tgtakaoka/kicad-library/README.md

## KiCad parts library

### ``connector``
Custom connector and socket.

 - ``DIP-48_W10.16mm.kicad_mod`` 48 pin ZIF socket footprint
 - ``bionic_connector`` custom connector for [Bionic projects](https://github.com/tgtakaoka/RetroCyborg)
 - ``DIP-48_W7.62mm.kicad_mod`` ``bionic_connector`` foot print

### ``cpu-16bit``
Retro 16-bit MPU/CPU.

 - ``MC68008P`` Motorola 8-bit MC68000 DIP-48
 - ``MN1613`` Panasonic MN1613
 - ``MN1613A`` Panasonic MN1613A DIP-42
 - ``NS32016N`` Natinal Semiconductor 16-bit NS32032 DIP-48
 - ``P8086`` Intel i8086
 - ``P8088`` Intel 8-bit i8086
 - ``P8095BH`` Intel i8096 DIP-48
 - ``TMS32C010NL`` Texas Instrument TMS32010 DSP
 - ``TMS9981`` Texas Instrument TMS9981
 - ``TMS9995`` Texas Instrument TMS9995
 - ``TMS99105`` Texas INstrumet TMS99105
 - ``uPD70108`` NEC V20 8-bit CMOS i80186 with i8080 emulation mode
 - ``uPD70116`` NEC V30 CMOS i80186 with i8080 emulation mode
 - ``Z8001`` Zilog Z8001 DIP-48
 - ``Z8002`` Zilog Z8002

### ``cpu-8bit``
Retro 8-bit MPU/CPU.

 - ``CDP1802`` RCA 1802
 - ``F3850`` Fairchild F8
 - ``HD6120`` Harris HD-6120 12-bit CPU
 - ``HD6301V1P`` Hitach CMOS MC6801, MC6803
 - ``IM6100`` Intersil IM6100 12-bit CPU
 - ``INS8060`` National Semiconductor SC/MP II
 - ``INS8070`` National Semiconductor SC/MP III
 - ``MC68HC11A8P`` Motorola MC68HC11 DIP-48
 - ``MC68HC11D3P`` Motorola MC68HC11 DIP-40
 - ``MC6800P`` Motorola MC6800
 - ``MC6802P`` Motorola MC6802
 - ``MC6803P`` Motorola MC6801, MC6803
 - ``MC6809P`` Motorola MC6809
 - ``MC6809EP`` Motorola MC6809E
 - ``MC146805E2P`` Motorola MC146805 DIP-40
 - ``MOS6502`` MOS Technology 6502, Rockwell 65C02, CMD 65SC02
 - ``NSC800N`` National Semiconductor CMOS Z80 with i8085 bus
 - ``P8048AH`` Intel i8048
 - ``P8051AH`` Intel i8051
 - ``P8085AH`` Intel i8085
 - ``TMP90C802A`` Toshiba TLCS-90
 - ``TMS7001`` Texas Instrument TMS7001
 - ``W65C02S`` Western Design Center CMOS 6502
 - ``W65C816`` Western Design Center CMOS 65816
 - ``Z8400`` Zilog Z80
 - ``Z8691`` Zilog Z8
 - ``Z8800`` Zilog Super Z8 DIP-48

### ``logic7400``
Standard TTL 7400 series.

 - ``74HCT126`` 74HCT126 quad tristate-buffer

### ``dcdc``
DC-DC Converter.

 - ``MAU105`` MINMAX MAU100 Series 5V in, 15V out, max 67mA
