tgtakaoka/kicad-library/(commit log)

2022-11-20 Convert to KiCAD 6 format
2023-12-12 Cleanup pre KiCad7 files
2023-12-14 Update connectors
2024-03-24 [connector] Add IC sockets with cortyard
2024-04-29 [bionic] Add library for RetroBionic
    [LED_CSL1901UW1_ROM.step, SOT-23_MC_MCH.step]
2024-10-29 Add USB Serial board GY232V2
2024-11-01 [11AA010-I_TT] Fix critical pin assignment bug
2024-11-01 Chane bionic library to project scope
    [kicad-library.kicad_pcb, kicad-library.kicad_sch]
2024-11-01 [bionic] Fix LED pin function
2025-01-10 [bionic] Update LED symbol
2025-02-28 [bionic] Remove extra pins and +15V pins
2025-03-06 [3m] Add 3M PLCC SMT Socket
2025-03-06 [aries] Add Aries 48-pin ZIF DIP Socket
2025-03-06 [rhom] Add Rhom LED
2025-03-06 [murata] Add Murata SMD inductor and Diode
2025-03-15 [nisshinbo] Fix NJW4191 pin name
2025-03-15 [bionic] Change DIP-64 footprint and 3D
2025-11-10 [3m] update 3D model from traceparts.com
2025-12-24 [3M] 84-pin PLCC SMT socket
2025-12-24 [TI] Cleanup foot print silk
2026-03-05 [ti] Add LDO, Driver, and 1G-gate
2026-10-26 [bionic] Model the SMD Bionic connector as populated
    Unpopulated positions have no pins and both end pins are straight
    through-hole, as on the boards; bionic_smt_header.py derives the model
    from KiCad's PinHeader_1x24 SMD model.
2026-10-26 [bionic] Add DIP-64 and SDIP-64 socket 3D models
    DIP-64 is two Akizuki 101591 (Neltron 6604S) round-pin strips cut to
    1x32; neltron.pretty/6604S_strip.py builds the strip from its datasheet
    dimensions. SDIP-64 is the Preci-Dip 117-83-764-41-005101 model from
    TraceParts, with the courtyard following its frame.
2026-10-26 [bionic] Model the THT Bionic connector as populated
    Unpopulated positions have no pins, as on the SMD connector; the model
    script, now bionic_header.py, handles both headers.
2026-10-26 [bionic] Add conn_swap.py to move projects to the populated connector models
2026-10-27 [3M] Drop the locating holes from the B-version PLCC sockets
    8444-21B1 and 8484-21B1 have no locating posts. Both are now SMD
    footprints like 8452 and 8468, and the 84-pin model sits on the board.
